Espeer5/PokerBot/README.md

# GLaDOS
Me 134 with Eddie, Josh, Leo, and Joy

## Next steps

### Accuracy/motion tracking
 - Improve accuracy

### Report Due 1/19
 - ROS Recording
 - Matlab Plotting
 - Write and turn-in report

### Contact detection
 - See goals3
