Espeer5/PokerBot/reports/week5/week5.pdf

## CS134: Robotics Systems

Team GLaDOS Weekly Goals 6

Progress:

1. All arm parts prototyped and assembled
2. Parts delivered
3. Suction cup system assembled and tested
4. Suction system refind by switching H-bridge component.
5. URDF made for custom hardware

To-Do:

- Get a poker mat prototype together and working
- Begin coding the manipulation of objects
- Start working on the game logic

Issues:

- None for now.

1
