Espeer5/PokerBot/reports/week2/rep2.pdf

## CS134: Robotics Systems

Team GLaDOS Weekly Report 1

Progress:

1. The robot hardware setup was improved over last week’s setup:
- The robot power and NUC were placed underneath the table to give the robot a fully unobstructed workspace.
- The robot cables were organized and secured around the joints, and full range of motions verified to be unobstructed by the cables.
2. The robot dimensions were measured and placed into the URDF file which was verified in Rviz.
3. Using the KinematicChain code from 133A, the robot kinematics were coded using a weighted psuedoinverse to provide robustness to singularities.
4. The robot was able to move to both joint positions and cartesian positions in the workspace.
5. A demo was created in which the robot takes in positions given at any time from ROS commands and moves to that goal and then back to the waiting position. The software builds up a queue of goals and moves to them in order, or waits at the ready position if there are no goals in the queue.
6. A gravity compensation controller was implemented to allow the robot to resist the strength of gravity. We found the value of our constants to be A = −1.8 and B = 0.4
7. We created plots to verify the tracking of the actual joint positions, velocities, and efforts to those which were commanded.

1

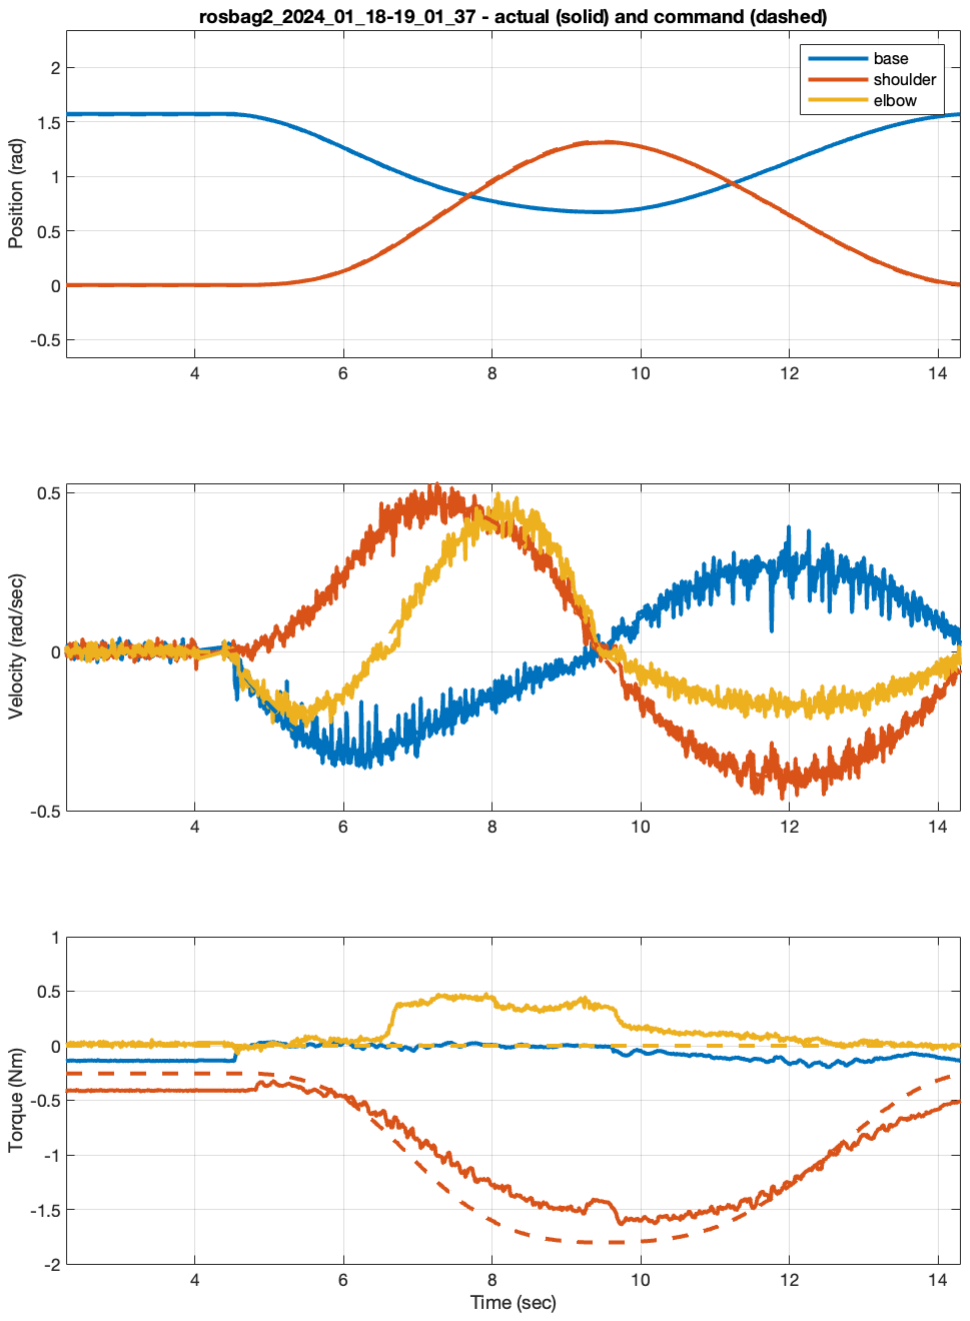
[picture p22: figure]

Joint tracking with a collision at t=6.4

To-Do:

- Improve the callibration of the robot to match the task space to the joint space. Currently the joints track well to their commanded positions but the corresponding tip position is off from expected by up to half a centimeter.

2

- Implement contact detection

Issues:

- We improved a lot of issues with measurements between the URDF and the actual robot which greatly improved the callibration of the robot and its task space position, but now we are unsure where the remining error stems from.

3
