Espeer5/PokerBot/reports/week1/wk1_rep.pdf

# CS134: Robotics Systems

### Team GLaDOS Weekly Report 1

### Progress:

1. The robot hardware was tested using the provided demo134 code and all worked.
2. The robot was fully assembled and is now functional.
3. Each team member set up ssh and remote desktop on their respective machines.

### 4. A team Github repository was created and setup with all team members able to work

on code together.

### 5. Code was written to allow the robot to move to a defined starting position from any initial position via a spline, and then execute a periodic waving motion after reaching

the start.

### Issues:

- We didn’t run into any particular issues this week.

### Wave Code: For the wave code we created a new package called wave. The full details

can be seen in the repo. (https://github.com/LeoBJenkins/GLaDOS) Here is the code for the wave demo node and trajectory:

#!/usr/bin/env python3

"""
A simple demo of the 3DOF robot in ME/CS 134. Causes the arm to execute a simple periodic waving motion.
"""

import numpy as np
import rclpy
from rclpy.node | import Node
from sensor_msgs.msg | import JointState
from wave.TrajectoryUtils | import *

# Constants

RATE = 100.0 # Hz

class Trajectory():

1

"""
Computes the positions and velocities of each joint based on the current time to be sent via the ROS node to the 3DOF robot.
"""

def __init__(self, q0):
self.q0a = np.array(q0).reshape(3, 1)
self.q0b = np.array([-1/2, -1/2, 1/2]).reshape(3,1) self.prevQ = self.q0a

def evaluate(self, t, dt):
if t < 5:
q, qdot = goto(t, 5, self.q0a, self.q0b)
else:
t_offs = t - 5
qdot = np.array([np.sin(t_offs)/2, np.sin(t_offs)/2, -np.sin(t_offs)/2]).reshape(3,1) q = self.prevQ + qdot * dt

self.prevQ = q

return q.flatten().tolist(), qdot.flatten().tolist()

class DemoNode(Node):
"""
Defines the ROS node which runs the periodic wave demo """

def __init__(self, name):
# Initialize the node, naming it as specified super().__init__(name)

# Create a temporary subscriber to grab the initial position. self.position0 = self.grabfbk() self.get_logger().info("Initial positions: %r" % self.position0)

# Create the Trajectory object

self.trajectory = Trajectory(self.position0)

# Create a message and publisher to send the joint commands. self.cmdmsg = JointState()

self.cmdpub = self.create_publisher(JointState, ’/joint_commands’, 10)

# Wait for a connection to happen. This isn’t necessary, but

# means we don’t start until the rest of the system is ready.

2

self.get_logger().info("Waiting for a /joint_commands subscriber...") while(not self.count_subscribers(’/joint_commands’)):
pass

# Create a subscriber to continually receive joint state messages. self.fbksub = self.create_subscription(

JointState, ’/joint_states’, self.recvfbk, 10)

# Create a timer to keep calculating/sending commands.

rate | = RATE
self.timer = self.create_timer(1/rate, self.sendcmd)
self.dt | = self.timer.timer_period_ns * 1e-9
self.t | = - self.dt
self.get_logger().info("Sending commands with dt of %f seconds (%fHz)" % (self.timer.timer_period_ns * 1e-9, rate))

# Shutdown

def shutdown(self):
# No particular cleanup, just shut down the node. self.destroy_node()

# Grab a single feedback - do not call this repeatedly. def grabfbk(self):

# Create a temporary handler to grab the position. def cb(fbkmsg):

self.grabpos = list(fbkmsg.position) self.grabready = True

# Temporarily subscribe to get just one message.

sub = self.create_subscription(JointState, ’/joint_states’, cb, 1) self.grabready = False
while not self.grabready:
rclpy.spin_once(self)
self.destroy_subscription(sub)

# Return the values.

return self.grabpos

# Receive feedback - called repeatedly by incoming messages. def recvfbk(self, fbkmsg):

# Just print the position (for now). print(list(fbkmsg.position))

pass

# Send a command - called repeatedly by the timer.

3

def sendcmd(self):

# To avoid any time jitter enforce a constant time step in # integrate to get the current time.

self.t += self.dt

# Compute the desired joint positions and velocities for this time. q, qdot = self.trajectory.evaluate(self.t, self.dt)

# Build up the message and publish.

self.cmdmsg.header.stamp = self.get_clock().now().to_msg()
self.cmdmsg.name | = [’one’, ’two’, ’three’]
self.cmdmsg.position | = q
self.cmdmsg.velocity | = qdot
self.cmdmsg.effort | = [0.0, 0.0, 0.0]
self.cmdpub.publish(self.cmdmsg)

def main(args=None):
"""
Main method which instantiates the node and runs the tranjectory. """
# Initialize ROS.

rclpy.init(args=args)

# Instantiate the DEMO node.

node = DemoNode(’demo’)

# Spin the node until interrupted. rclpy.spin(node)

# Shutdown the node and ROS. node.shutdown()

rclpy.shutdown()

if __name__ == "__main__": main()

4
