Espeer5/PokerBot/reports/week3/rep3.tex

\documentclass[12 pt]{article}

% Fonts/Symbols/Colors
\usepackage{fullpage}
\usepackage{amsthm}
\usepackage{amsmath}
\usepackage{xcolor}
\usepackage{amssymb}
\usepackage{verbatim}
\usepackage[utf8x]{inputenc}
\usepackage{helvet}
\renewcommand{\familydefault}{\sfdefault}

% Question counter
\newcounter{qnum}

% Question Formatting
\newcommand{\new}[1]{\bigskip \noindent \color{blue} \textbf{#1}\medskip}
\newcommand{\response}[1]{\color{black} #1 \medskip}
\newcommand{\q}[1]{\response{\emph{#1}}}
\newcommand{\Q}[1]{\stepcounter{qnum}\new{Goal {\arabic{qnum}}:} \q{#1}}

% INSERT WEEK NUMBER HERE
\newcommand{\setnum}{4}

\begin{document}

% Title Section
\begin{center}
    \Large \color{blue} CS134: Robotics Systems\color{black}
    \begin{center}\normalsize Team GLaDOS Weekly Goals \setnum{}\end{center}
    \noindent{\color{black} \rule{\linewidth}{0.5mm} }
\end{center}

% Body
\textbf{Progress}:
    \begin{enumerate}
        \item Contact detection was added to the robot and calibrated
        \item A computer vision model which detected orange pucks and strips was 
        created
        \item Code was written using aspect ratio to differentiate between pucks
        and rectangular strips
        \item Robot trajectory code was written which could move to any point, 
        tap on the orange puck where it was located, and tap on both long sides 
        of the orange rectangle wherever it was placed
        \item Our team decided on our project idea! We would like to build a poker 
        playing robot
    \end{enumerate}

\textbf{To-Do}:
    \begin{itemize}
        \item Find a card detection model, test it, and get a project proposal 
        together!
    \end{itemize}

\textbf{Issues}:
    \begin{itemize}
        \item None for the moment.
    \end{itemize}

\end{document}
