Espeer5/PokerBot/reports/week6/week6.pdf

## CS134: Robotics Systems

Team GLaDOS Weekly Goals 7

Progress:

1. Trajectory sequences programmed for the robot to move from place to place in both joint and task space.
2. Card detector massively improved for close to 100% accuraccy
3. Cards and chips lifted and dropped using the suction system and movements in task space.
4. Cards successfully flipped using the suction system
5. CAD design and model produced for adding an additional DOF to the robot’s wrist.

To-Do:

- Dial in movements of the robot to have a more precise and smooth pickup and drop sequence as well as flipping sequence.
- Add the additional DOF to the robot’s wrist.
- Incorporate the detectors into the robot movements - in particular, this week be able to find a card in the workspace and pick it up and move it to another specified location in task space.
- Program the dealing sequence.

Issues:

- Progress is slow....

1
