Espeer5/PokerBot/reports/week3/rep3.pdf

## CS134: Robotics Systems

Team GLaDOS Weekly Goals 4

Progress:

1. Contact detection was added to the robot and calibrated
2. A computer vision model which detected orange pucks and strips was created
3. Code was written using aspect ratio to differentiate between pucks and rectangular strips
4. Robot trajectory code was written which could move to any point, tap on the orange puck where it was located, and tap on both long sides of the orange rectangle wherever it was placed
5. Our team decided on our project idea! We would like to build a poker playing robot

To-Do:

- Find a card detection model, test it, and get a project proposal together!

Issues:

- None for the moment.

1
