Espeer5/PokerBot/reports/week2/error.png

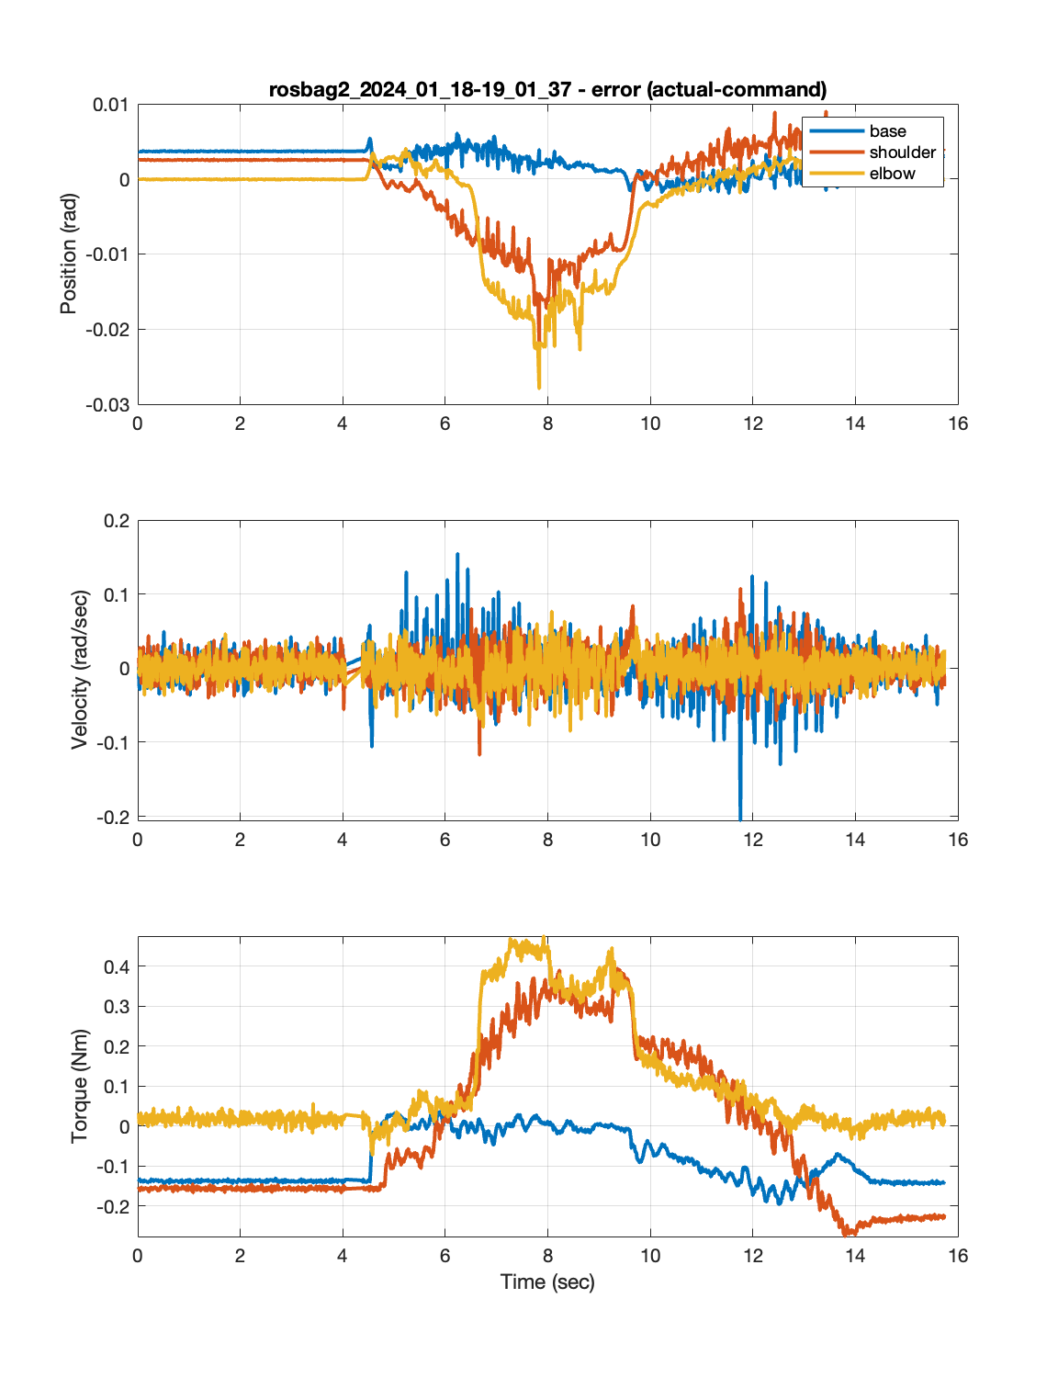
reports/week2/error.png
