Espeer5/PokerBot/pb_utils/meshes/base_Ass.STL

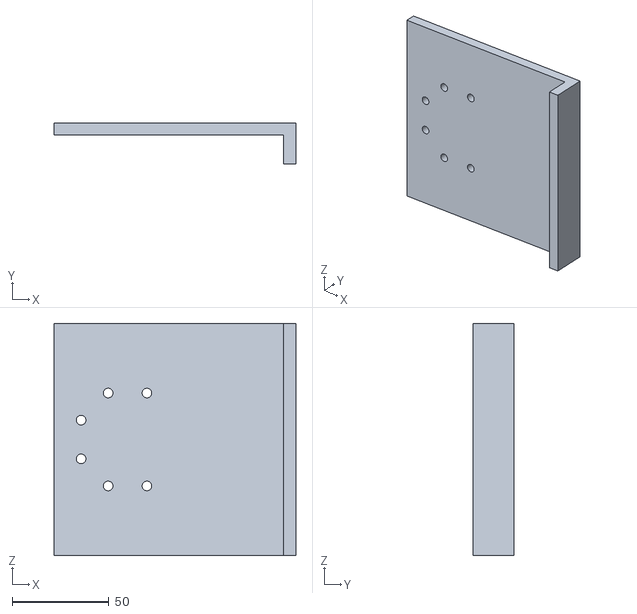
[picture p24: CAD file, 2024-02-12]
pb_utils/meshes/base_Ass.STL
125.0 x 21.3 x 120.0
