Espeer5/PokerBot/pb_utils/meshes/endeff_ass.STL

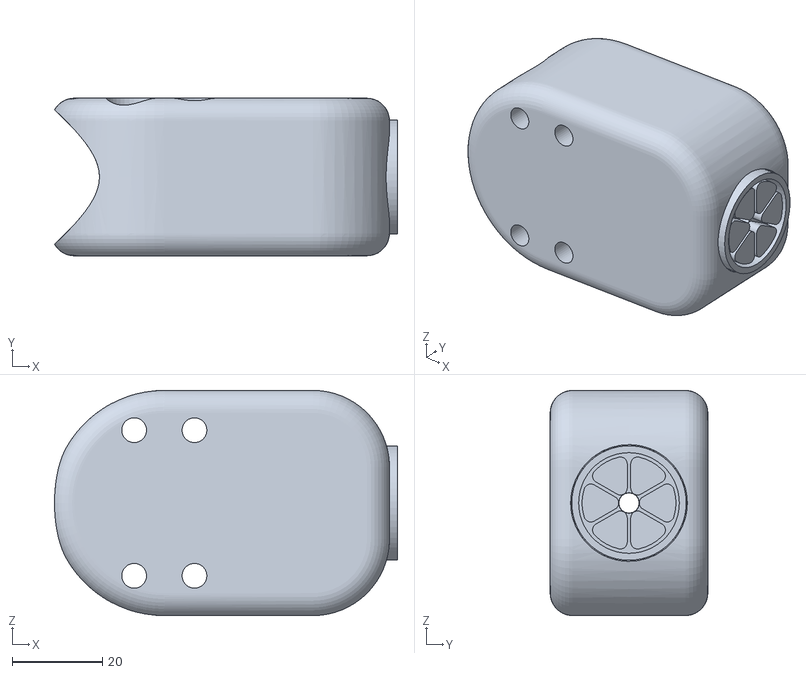
[picture p25: CAD file, 2024-02-12]
pb_utils/meshes/endeff_ass.STL
76.2 x 35.0 x 50.0
