Espeer5/PokerBot/pb_utils/meshes/lb_ass.STL

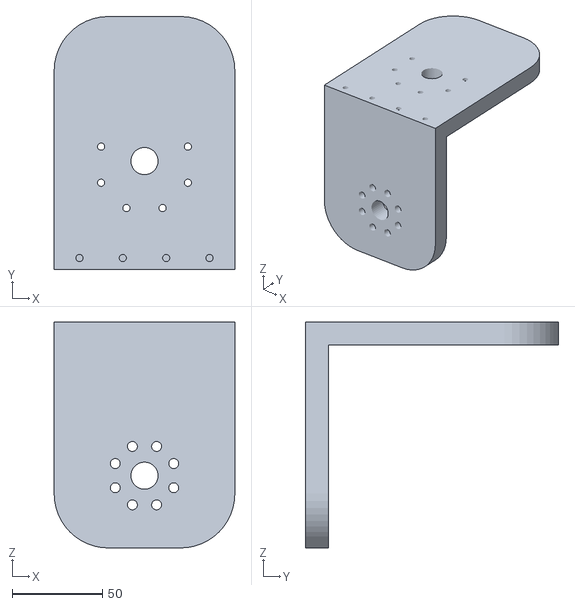
[picture p26: CAD file, 2024-02-12]
pb_utils/meshes/lb_ass.STL
100.0 x 140.0 x 125.0
