Espeer5/PokerBot/pb_utils/meshes/base_motor_mount.STL

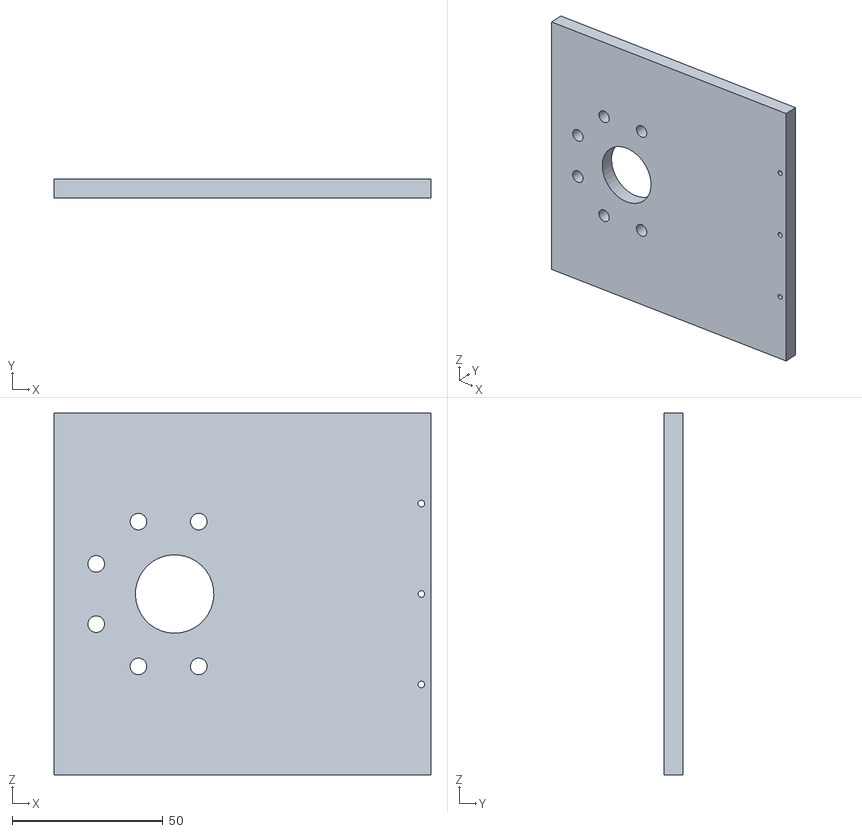
[picture p27: CAD file, 2024-02-07]
pb_utils/meshes/base_motor_mount.STL
125.0 x 6.35 x 120.0
