Espeer5/PokerBot/pb_utils/meshes/End_Effector_Bottom_V3.STL

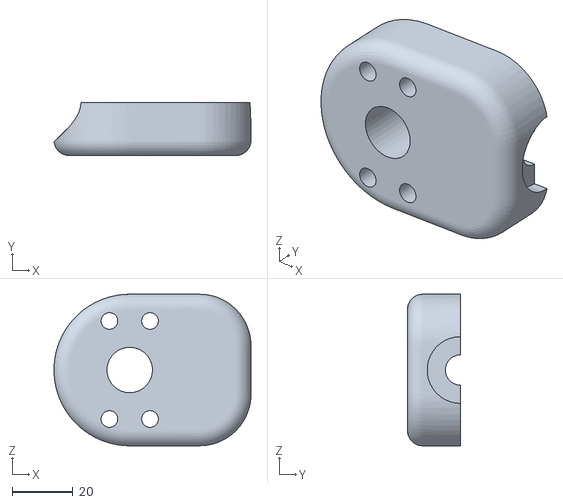
[picture p28: CAD file, 2024-02-07]
pb_utils/meshes/End_Effector_Bottom_V3.STL
65.0 x 17.5 x 50.0
