Espeer5/PokerBot/pb_utils/meshes/L-Bracket-Upper-V3.STL

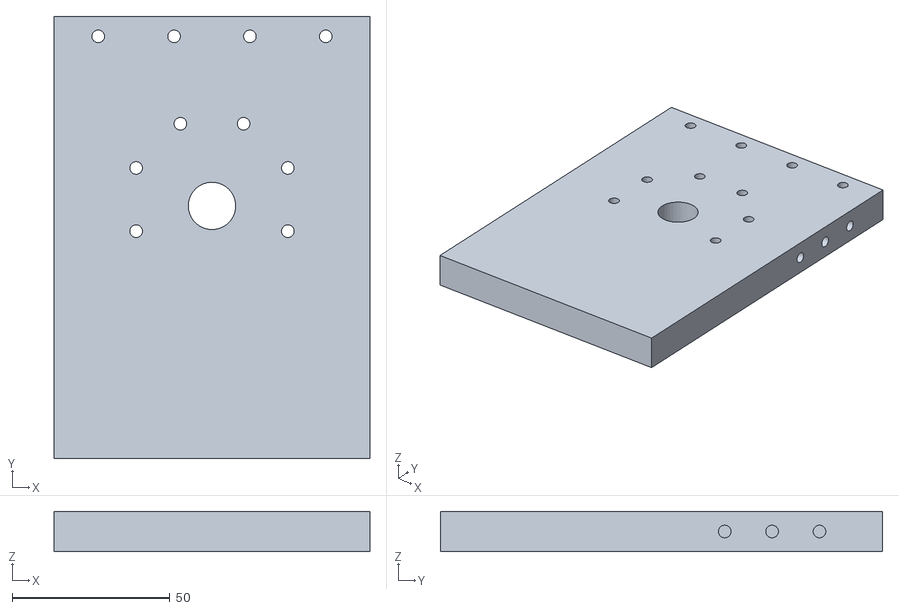
[picture p30: CAD file, 2024-02-07]
pb_utils/meshes/L-Bracket-Upper-V3.STL
100.0 x 140.0 x 12.7
