Espeer5/PokerBot/pb_utils/meshes/L-Bracket-Lower-V3.STL

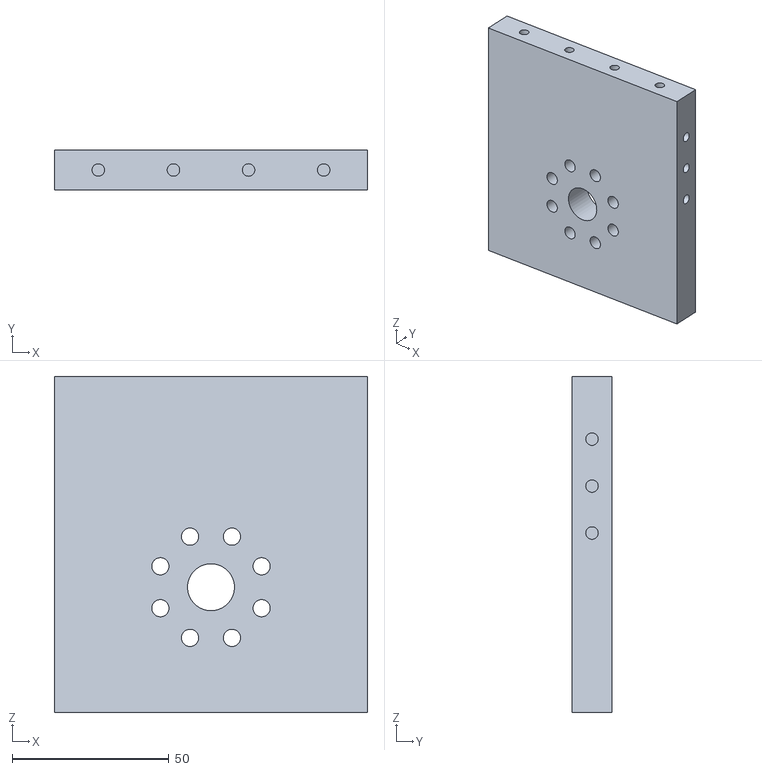
[picture p31: CAD file, 2024-02-07]
pb_utils/meshes/L-Bracket-Lower-V3.STL
100.0 x 12.7 x 107.3
