Espeer5/PokerBot/pb_utils/meshes/18in_Arm_V2.STL

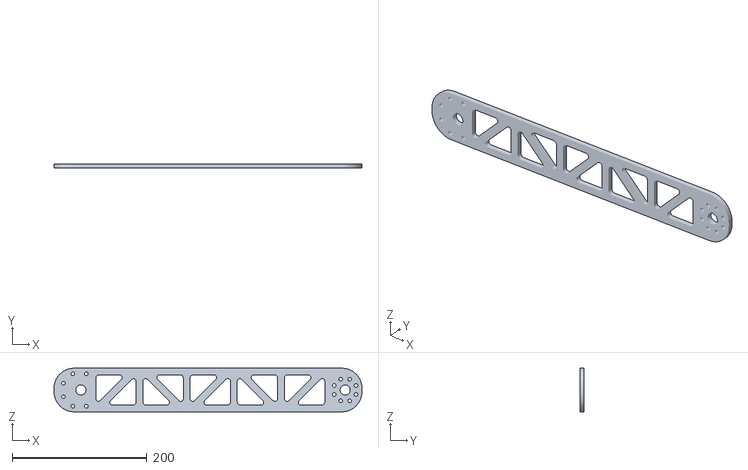
[picture p32: CAD file, 2024-02-07]
pb_utils/meshes/18in_Arm_V2.STL
457.2 x 6.35 x 65.0
