Espeer5/PokerBot/pb_utils/meshes/base_motor_mount_lip.STL

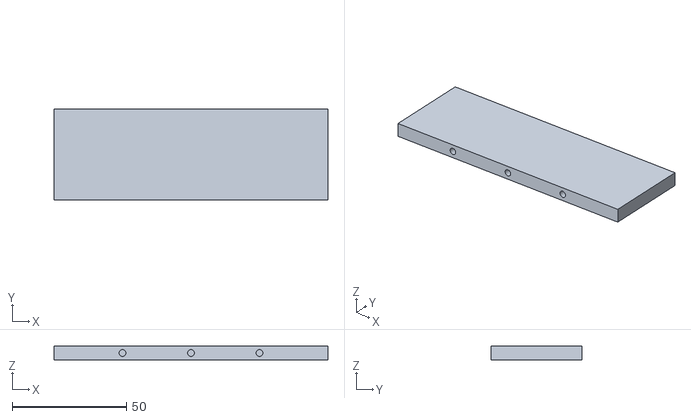
[picture p33: CAD file, 2024-02-07]
pb_utils/meshes/base_motor_mount_lip.STL
120.0 x 40.0 x 6.35
