Espeer5/PokerBot/pb_utils/meshes/16in_Arm_V2.STL

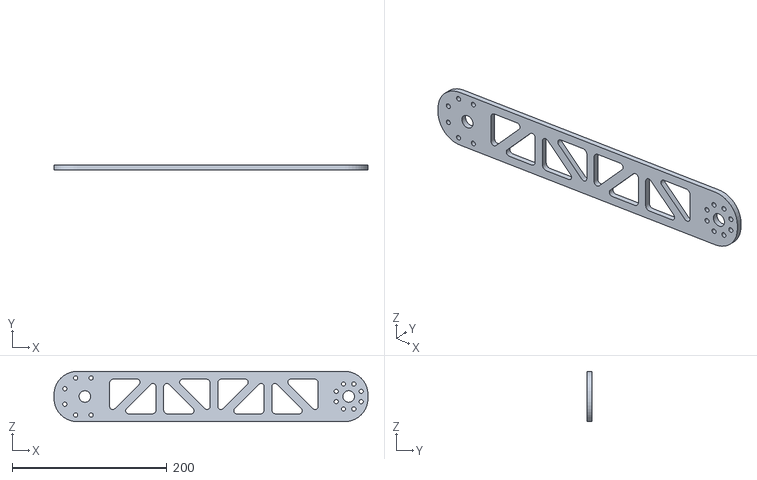
[picture p34: CAD file, 2024-02-07]
pb_utils/meshes/16in_Arm_V2.STL
406.4 x 6.35 x 65.0
