Espeer5/PokerBot/pb_utils/meshes/upperarm.stl

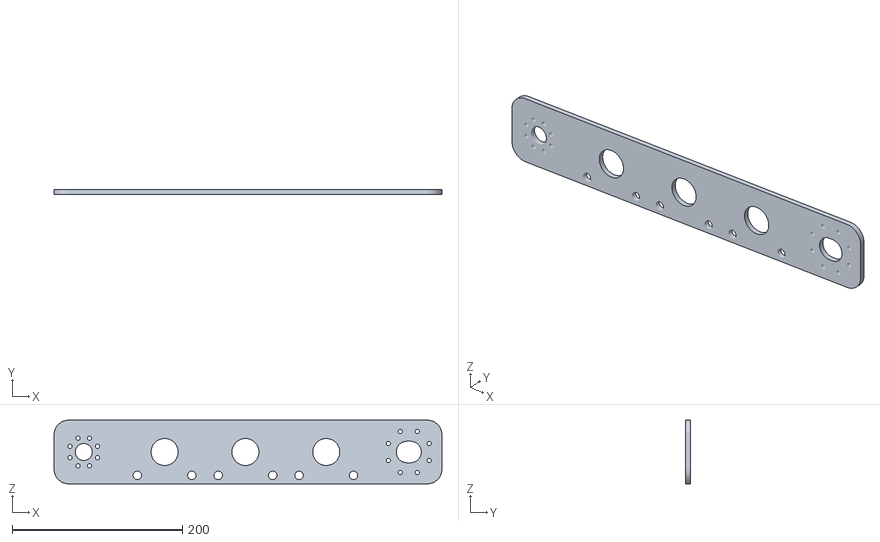
[picture p35: CAD file, 2024-01-19]
pb_utils/meshes/upperarm.stl
456.0 x 5.70 x 75.0
