Espeer5/PokerBot/pb_utils/meshes/pointer.stl

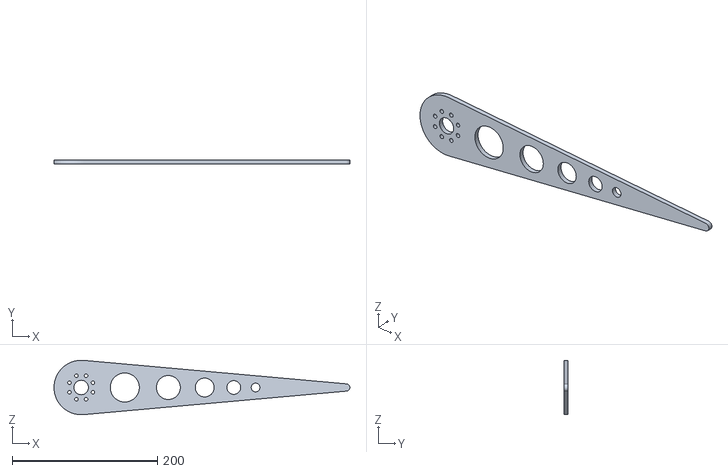
[picture p36: CAD file, 2024-01-19]
pb_utils/meshes/pointer.stl
407.4 x 5.70 x 75.0
