Espeer5/PokerBot/pb_utils/meshes/X5.stl

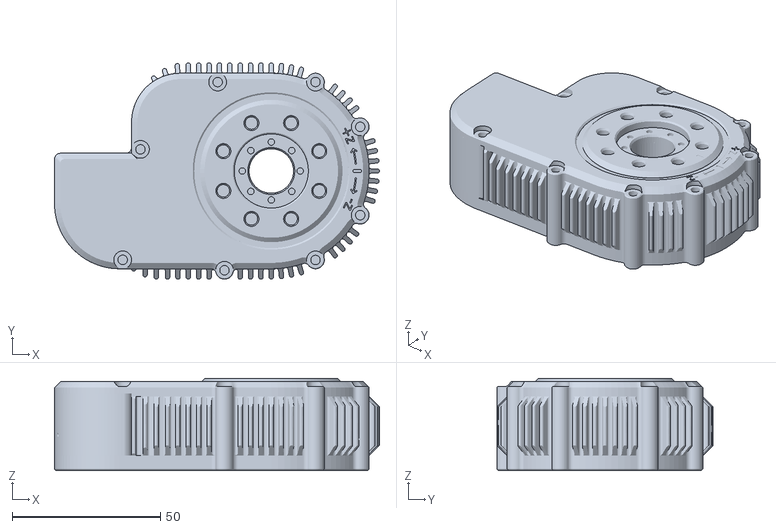
[picture p37: CAD file, 2024-01-17]
pb_utils/meshes/X5.stl
109.6 x 73.0 x 31.1
