Espeer5/PokerBot/pb_utils/meshes/X8.stl

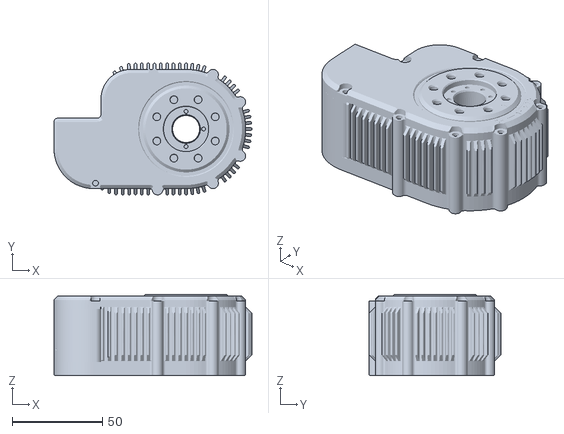
[picture p38: CAD file, 2024-01-17]
pb_utils/meshes/X8.stl
109.6 x 73.0 x 45.0
