Espeer5/PokerBot/pb_utils/meshes/basiclink.stl

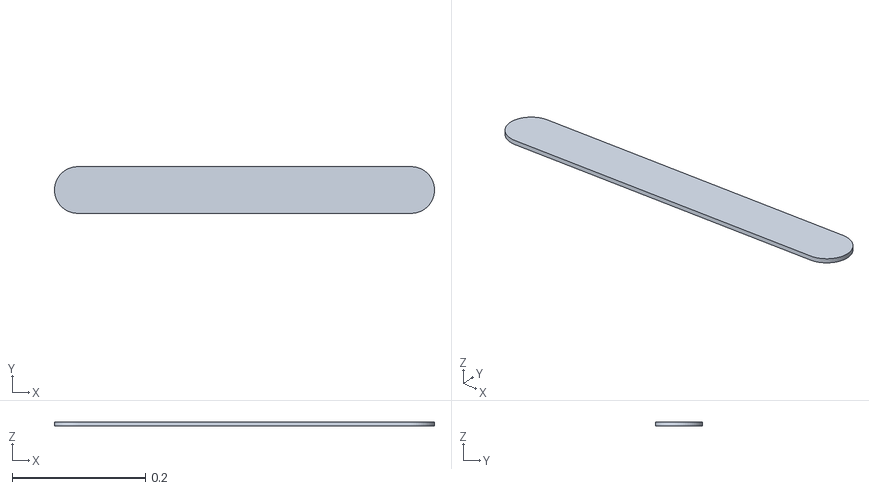
[picture p39: CAD file, 2024-01-17]
pb_utils/meshes/basiclink.stl
0.57 x 0.07 x 0.00635
