Espeer5/PokerBot/playing_card_detector/Cards.py

############## Playing Card Detector Functions ###############
#
# Author: Evan Juras
# Date: 9/5/17
# Description: Functions and classes for CardDetector.py that perform 
# various steps of the card detection algorithm


# Import necessary packages
import numpy as np
import cv2
import time

### Constants ###

# Adaptive threshold levels
BKG_THRESH = 60
CARD_THRESH = 30

# Width and height of card corner, where rank and suit are
# CORNER_WIDTH = 32
# CORNER_HEIGHT = 84
CORNER_H0 = 12
CORNER_WIDTH = 24
CORNER_HEIGHT = 80

# Dimensions of rank train images
RANK_WIDTH = 70
RANK_HEIGHT = 125

# Dimensions of suit train images
SUIT_WIDTH = 70
SUIT_HEIGHT = 100

# RANK_DIFF_MAX = 2000
# SUIT_DIFF_MAX = 700

CARD_MAX_AREA = 30000
CARD_MIN_AREA = 6250

font = cv2.FONT_HERSHEY_SIMPLEX

### Structures to hold query card and train card information ###

class Query_card:
    """Structure to store information about query cards in the camera image."""

    def __init__(self):
        self.contour = [] # Contour of card
        self.width, self.height = 0, 0 # Width and height of card
        self.corner_pts = [] # Corner points of card
        self.center = [] # Center point of card
        self.warp = [] # 200x300, flattened, grayed, blurred image
        self.rank_img = [] # Thresholded, sized image of card's rank
        self.suit_img = [] # Thresholded, sized image of card's suit
        self.rank_img2 = [] # Thresholded, sized image of card's rank (bottom right)
        self.suit_img2 = [] # Thresholded, sized image of card's suit (bottom right)
        self.best_rank_match = "Unknown" # Best matched rank
        self.best_suit_match = "Unknown" # Best matched suit
        self.rank_diff = 0 # Difference between rank image and best matched train rank image
        self.suit_diff = 0 # Difference between suit image and best matched train suit image

class Train_ranks:
    """Structure to store information about train rank images."""

    def __init__(self):
        self.img = [] # Thresholded, sized rank image loaded from hard drive
        self.name = "Placeholder"

class Train_suits:
    """Structure to store information about train suit images."""

    def __init__(self):
        self.img = [] # Thresholded, sized suit image loaded from hard drive
        self.name = "Placeholder"

### Functions ###
def load_ranks(filepath):
    """Loads rank images from directory specified by filepath. Stores
    them in a list of Train_ranks objects."""

    train_ranks = []
    i = 0
    
    for Rank in ['Ace','Two','Three','Four','Five','Six','Seven',
                 'Eight','Nine','Ten','Jack','Queen','King']:
        train_ranks.append(Train_ranks())
        train_ranks[i].name = Rank
        filename = Rank + '.jpg'
        train_ranks[i].img = cv2.imread(filepath+filename, cv2.IMREAD_GRAYSCALE)
        i = i + 1

    return train_ranks

def load_suits(filepath):
    """Loads suit images from directory specified by filepath. Stores
    them in a list of Train_suits objects."""

    train_suits = []
    i = 0
    
    for Suit in ['Spades','Diamonds','Clubs','Hearts']:
        train_suits.append(Train_suits())
        train_suits[i].name = Suit
        filename = Suit + '.jpg'
        train_suits[i].img = cv2.imread(filepath+filename, cv2.IMREAD_GRAYSCALE)
        i = i + 1

    return train_suits

def preprocess_image(image):
    """Returns a grayed, blurred, and adaptively thresholded camera image."""

    gray = cv2.cvtColor(image,cv2.COLOR_BGR2GRAY)
    blur = cv2.GaussianBlur(gray,(5,5),0)

    # The best threshold level depends on the ambient lighting conditions.
    # For bright lighting, a high threshold must be used to isolate the cards
    # from the background. For dim lighting, a low threshold must be used.
    # To make the card detector independent of lighting conditions, the
    # following adaptive threshold method is used.
    #
    # A background pixel in the center top of the image is sampled to determine
    # its intensity. The adaptive threshold is set at 50 (THRESH_ADDER) higher
    # than that. This allows the threshold to adapt to the lighting conditions.
    img_w, img_h = np.shape(image)[:2]
    bkg_level = gray[int(img_h/100)][int(img_w/2)]
    thresh_level = bkg_level + BKG_THRESH

    retval, thresh = cv2.threshold(blur,thresh_level,255,cv2.THRESH_BINARY)
    
    return thresh

def find_cards(thresh_image):
    """Finds all card-sized contours in a thresholded camera image.
    Returns the number of cards, and a list of card contours sorted
    from largest to smallest."""

    # Find contours and sort their indices by contour size
    cnts,hier = cv2.findContours(thresh_image,cv2.RETR_TREE,cv2.CHAIN_APPROX_SIMPLE)
    index_sort = sorted(range(len(cnts)), key=lambda i : cv2.contourArea(cnts[i]),reverse=True)

    # If there are no contours, do nothing
    if len(cnts) == 0:
        return [], []
    
    # Otherwise, initialize empty sorted contour and hierarchy lists
    cnts_sort = []
    hier_sort = []
    cnt_is_card = np.zeros(len(cnts),dtype=int)

    # Fill empty lists with sorted contour and sorted hierarchy. Now,
    # the indices of the contour list still correspond with those of
    # the hierarchy list. The hierarchy array can be used to check if
    # the contours have parents or not.
    for i in index_sort:
        cnts_sort.append(cnts[i])
        hier_sort.append(hier[0][i])

    # Determine which of the contours are cards by applying the
    # following criteria: 1) Smaller area than the maximum card size,
    # 2), bigger area than the minimum card size, 3) have no parents,
    # and 4) have four corners

    for i in range(len(cnts_sort)):
        size = cv2.contourArea(cnts_sort[i])
        peri = cv2.arcLength(cnts_sort[i],True)
        approx = cv2.approxPolyDP(cnts_sort[i],0.01*peri,True)
        
        if ((size < CARD_MAX_AREA) and (size > CARD_MIN_AREA)
            and (hier_sort[i][3] == -1) and (len(approx) == 4)):
            cnt_is_card[i] = 1

    return cnts_sort, cnt_is_card

def get_rank_and_suit_images(qCard, bottom_right=False):
    # Grab corner of warped card image and do a 4x zoom
    qCard_warp = qCard.warp
    if bottom_right:
        qCard_warp = cv2.rotate(qCard_warp, cv2.ROTATE_180)

    cv2.imshow("card", qCard_warp)
    cv2.waitKey(0)

    Qcorner = qCard_warp[CORNER_H0:CORNER_HEIGHT, 0:CORNER_WIDTH]

    # print("Qcorner bottom-right=", Qcorner.shape)
    # exit()

    cv2.imshow("corner", Qcorner)
    cv2.waitKey(0)

    Qcorner_zoom = cv2.resize(Qcorner, (0,0), fx=4, fy=4)

    # Sample known white pixel intensity to determine good threshold level
    white_level = Qcorner_zoom[15,int((CORNER_WIDTH*4)/2)]
    thresh_level = white_level - CARD_THRESH
    if (thresh_level <= 0):
        thresh_level = 1
    retval, query_thresh = cv2.threshold(Qcorner_zoom, thresh_level, 255, cv2. THRESH_BINARY_INV)

    cv2.imshow("query threshold", query_thresh)
    cv2.waitKey(0)
    
    # Split in to top and bottom half (top shows rank, bottom shows suit)
    Qrank = query_thresh[20:185, 0:128]
    Qsuit = query_thresh[186:336, 0:128]

    # Find rank contour and bounding rectangle, isolate and find largest contour
    Qrank_cnts, hier = cv2.findContours(Qrank, cv2.RETR_TREE,cv2.CHAIN_APPROX_SIMPLE)
    Qrank_cnts = sorted(Qrank_cnts, key=cv2.contourArea, reverse=True)

    # Find bounding rectangle for largest contour, use it to resize query rank
    # image to match dimensions of the train rank image
    rank_image = np.array([])
    if len(Qrank_cnts) != 0:
        x1,y1,w1,h1 = cv2.boundingRect(Qrank_cnts[0])
        Qrank_roi = Qrank[y1:y1+h1, x1:x1+w1]
        Qrank_sized = cv2.resize(Qrank_roi, (RANK_WIDTH,RANK_HEIGHT), 0, 0)
        rank_image = Qrank_sized

    # Find suit contour and bounding rectangle, isolate and find largest contour
    Qsuit_cnts, hier = cv2.findContours(Qsuit, cv2.RETR_TREE,cv2.CHAIN_APPROX_SIMPLE)
    Qsuit_cnts = sorted(Qsuit_cnts, key=cv2.contourArea,reverse=True)
    
    # Find bounding rectangle for largest contour, use it to resize query suit
    # image to match dimensions of the train suit image
    suit_image = np.array([])
    if len(Qsuit_cnts) != 0:
        x2,y2,w2,h2 = cv2.boundingRect(Qsuit_cnts[0])
        Qsuit_roi = Qsuit[y2:y2+h2, x2:x2+w2]
        Qsuit_sized = cv2.resize(Qsuit_roi, (SUIT_WIDTH, SUIT_HEIGHT), 0, 0)
        suit_image = Qsuit_sized

    return rank_image, suit_image

def preprocess_card(contour, image):
    """Uses contour to find information about the query card. Isolates rank
    and suit images from the card."""

    # Initialize new Query_card object
    qCard = Query_card()

    qCard.contour = contour

    # Find perimeter of card and use it to approximate corner points
    peri = cv2.arcLength(contour,True)
    approx = cv2.approxPolyDP(contour,0.01*peri,True)
    pts = np.float32(approx)
    qCard.corner_pts = pts

    # Find width and height of card's bounding rectangle
    x,y,w,h = cv2.boundingRect(contour)
    qCard.width, qCard.height = w, h

    # Find center point of card by taking x and y average of the four corners.
    average = np.sum(pts, axis=0)/len(pts)
    cent_x = int(average[0][0])
    cent_y = int(average[0][1])
    qCard.center = [cent_x, cent_y]

    cv2.imshow("pre-flattener", image)
    cv2.waitKey(0)
    # Warp card into 200x300 flattened image using perspective transform
    qCard.warp = flattener(image, pts, w, h)

    qCard.rank_img, qCard.suit_img = get_rank_and_suit_images(qCard)
    qCard.rank_img2, qCard.suit_img2 = get_rank_and_suit_images(qCard, bottom_right=True)

    # assert qCard.rank_img.shape == qCard.rank_img2.shape, f"{qCard.rank_img.shape}, {qCard.rank_img2.shape}"
    # assert qCard.suit_img.shape == qCard.suit_img2.shape, f"{qCard.suit_img.shape}, {qCard.suit_img2.shape}"
    return qCard

def match_card(qCard, train_ranks, train_suits):
    """Finds best rank and suit matches for the query card. Differences
    the query card rank and suit images with the train rank and suit images.
    The best match is the rank or suit image that has the least difference."""

    best_rank_match_diff = 10000
    best_suit_match_diff = 10000
    # best_rank_match_name = "Unknown"
    # best_suit_match_name = "Unknown"
    best_rank_name = "Unknown"
    best_suit_name = "Unknown"
    i = 0

    # If no contours were found in query card in preprocess_card function,
    # the img size is zero, so skip the differencing process
    # (card will be left as Unknown)
    
        
    # Difference the query card rank image from each of the train rank images,
    # and store the result with the least difference
    # cv2.imshow("Rank Image 1", qCard.rank_img)
    # cv2.waitKey(0)

    # cv2.imshow("Rank Image 2", qCard.rank_img2)
    # cv2.waitKey(0)

    # cv2.imshow("suit Image 1", qCard.suit_img)
    # cv2.waitKey(0)

    # cv2.imshow("suit Image 2", qCard.suit_img2)
    # cv2.waitKey(0)

    for Trank in train_ranks:

        rank_diff = best_rank_match_diff
        if (len(qCard.rank_img) != 0):
            diff_img = cv2.absdiff(qCard.rank_img, Trank.img)
            rank_diff = int(np.sum(diff_img)/255)

        rank_diff2 = best_rank_match_diff
        if (len(qCard.rank_img2) != 0):
            diff_img2 = cv2.absdiff(qCard.rank_img2, Trank.img)
            rank_diff2 = int(np.sum(diff_img2)/255)
            
        best_rank_diff = min(rank_diff, rank_diff2)
            
        if best_rank_diff < best_rank_match_diff:
            best_rank_diff_img = diff_img
            best_rank_match_diff = rank_diff
            best_rank_name = Trank.name

    # cv2.imshow("DIFF", best_rank_diff_img) 
    # # waits for user to press any key 
    # # (this is necessary to avoid Python kernel form crashing) 
    # cv2.waitKey(0) 

    # Same process with suit images
    for Tsuit in train_suits:
            
        suit_diff = best_suit_match_diff
        if (len(qCard.suit_img) != 0):
            diff_img = cv2.absdiff(qCard.suit_img, Tsuit.img)
            suit_diff = int(np.sum(diff_img)/255)

        suit_diff2 = best_suit_match_diff
        if (len(qCard.suit_img2) != 0):
            diff_img2 = cv2.absdiff(qCard.suit_img2, Tsuit.img)
            suit_diff2 = int(np.sum(diff_img2)/255)

        suit_diff = min(suit_diff, suit_diff2)
        
        if suit_diff < best_suit_match_diff:
            # best_suit_diff_img = diff_img
            best_suit_match_diff = suit_diff
            best_suit_name = Tsuit.name

    # Combine best rank match and best suit match to get query card's identity.
    # If the best matches have too high of a difference value, card identity
    # is still Unknown
    # if (best_rank_match_diff < RANK_DIFF_MAX):
    best_rank_match_name = best_rank_name

    # if (best_suit_match_diff < SUIT_DIFF_MAX):
    best_suit_match_name = best_suit_name

    # Return the identiy of the card and the quality of the suit and rank match
    return best_rank_match_name, best_suit_match_name, best_rank_match_diff, best_suit_match_diff
    
    
def draw_results(image, qCard):
    """Draw the card name, center point, and contour on the camera image."""

    x = qCard.center[0]
    y = qCard.center[1]
    cv2.circle(image,(x,y),5,(255,0,0),-1)

    rank_name = qCard.best_rank_match
    suit_name = qCard.best_suit_match

    # Draw card name twice, so letters have black outline
    cv2.putText(image,(rank_name+' of'),(x-60,y-10),font,1,(0,0,0),3,cv2.LINE_AA)
    cv2.putText(image,(rank_name+' of'),(x-60,y-10),font,1,(50,200,200),2,cv2.LINE_AA)

    cv2.putText(image,suit_name,(x-60,y+25),font,1,(0,0,0),3,cv2.LINE_AA)
    cv2.putText(image,suit_name,(x-60,y+25),font,1,(50,200,200),2,cv2.LINE_AA)
    
    # Can draw difference value for troubleshooting purposes
    # (commented out during normal operation)
    #r_diff = str(qCard.rank_diff)
    #s_diff = str(qCard.suit_diff)
    #cv2.putText(image,r_diff,(x+20,y+30),font,0.5,(0,0,255),1,cv2.LINE_AA)
    #cv2.putText(image,s_diff,(x+20,y+50),font,0.5,(0,0,255),1,cv2.LINE_AA)

    return image

def flattener(image, pts, w, h):
    """Flattens an image of a card into a top-down 200x300 perspective.
    Returns the flattened, re-sized, grayed image.
    See www.pyimagesearch.com/2014/08/25/4-point-opencv-getperspective-transform-example/"""
    temp_rect = np.zeros((4,2), dtype = "float32")
    
    s = np.sum(pts, axis = 2)

    tl = pts[np.argmin(s)]
    br = pts[np.argmax(s)]

    diff = np.diff(pts, axis = -1)
    tr = pts[np.argmin(diff)]
    bl = pts[np.argmax(diff)]

    # Need to create an array listing points in order of
    # [top left, top right, bottom right, bottom left]
    # before doing the perspective transform

    if w <= 0.8*h: # If card is vertically oriented
        temp_rect[0] = tl
        temp_rect[1] = tr
        temp_rect[2] = br
        temp_rect[3] = bl

    if w >= 1.2*h: # If card is horizontally oriented
        temp_rect[0] = bl
        temp_rect[1] = tl
        temp_rect[2] = tr
        temp_rect[3] = br

    # If the card is 'diamond' oriented, a different algorithm
    # has to be used to identify which point is top left, top right
    # bottom left, and bottom right.
    
    if w > 0.8*h and w < 1.2*h: #If card is diamond oriented
        # If furthest left point is higher than furthest right point,
        # card is tilted to the left.
        if pts[1][0][1] <= pts[3][0][1]:
            # If card is titled to the left, approxPolyDP returns points
            # in this order: top right, top left, bottom left, bottom right
            temp_rect[0] = pts[1][0] # Top left
            temp_rect[1] = pts[0][0] # Top right
            temp_rect[2] = pts[3][0] # Bottom right
            temp_rect[3] = pts[2][0] # Bottom left

        # If furthest left point is lower than furthest right point,
        # card is tilted to the right
        if pts[1][0][1] > pts[3][0][1]:
            # If card is titled to the right, approxPolyDP returns points
            # in this order: top left, bottom left, bottom right, top right
            temp_rect[0] = pts[0][0] # Top left
            temp_rect[1] = pts[3][0] # Top right
            temp_rect[2] = pts[2][0] # Bottom right
            temp_rect[3] = pts[1][0] # Bottom left
            
        
    maxWidth = 200 + 100
    maxHeight = 300 + 100

    # Create destination array, calculate perspective transform matrix,
    # and warp card image
    dst = np.array([[0,0],[maxWidth-1,0],[maxWidth-1,maxHeight-1],[0, maxHeight-1]], np.float32)
    M = cv2.getPerspectiveTransform(temp_rect,dst)
    warp = cv2.warpPerspective(image, M, (maxWidth, maxHeight))
    warp = cv2.cvtColor(warp,cv2.COLOR_BGR2GRAY)

    return warp
