Espeer5/PokerBot/(commit log)

2024-01-17 Add basic134
    Downloaded from canvas.
    [X5.stl, X8.stl, basiclink.stl, threedofexample.urdf]
2024-01-17 Filled out URDF in demo134
    [threedofexample.urdf]
2024-01-18 Add KinematicChain to point code
    KinematicChain from 133a
2024-01-18 Working on demo
    [threedofexample.urdf]
2024-01-18 WIP 1_18
    [threedofexample.urdf]
2024-01-18 add sol kinematic chain
2024-01-18 receives commands from terminal correctly
    [threedofexample.urdf]
2024-01-19 Calibrate positioning; goals3
    [threedofexample.urdf]
2024-02-05 New Detectors and Pump control util
2024-02-05 add value checking on pwm output
2024-02-07 upload stls to basic134 meshes
    [16in_Arm_V2.STL, 18in_Arm_V2.STL, End_Effector_Bottom_V3.STL, End_Effector_Top_V3.STL, L-Bracket-Lower-V3.STL, L-Bracket-Upper-V3.STL, base motor mount lip.STL, base motor mount.STL]
2024-02-12 completed, functional URDF
    [16in_Arm_V2.STL, 18in_Arm_V2.STL, End_Effector_Bottom_V3.STL, End_Effector_Top_V3.STL, L-Bracket-Lower-V3.STL, L-Bracket-Upper-V3.STL, base_Ass.STL, base_motor_mount.STL]
2024-02-14 Gravity detection, joint-spline pickup/put-down
    [16in_Arm_V2.STL, 18in_Arm_V2.STL, End_Effector_Bottom_V3.STL, End_Effector_Top_V3.STL, L-Bracket-Lower-V3.STL, L-Bracket-Upper-V3.STL, X5.stl, X8.stl]
